HeyPCB/kestrel-fc/media/circuit-world.png

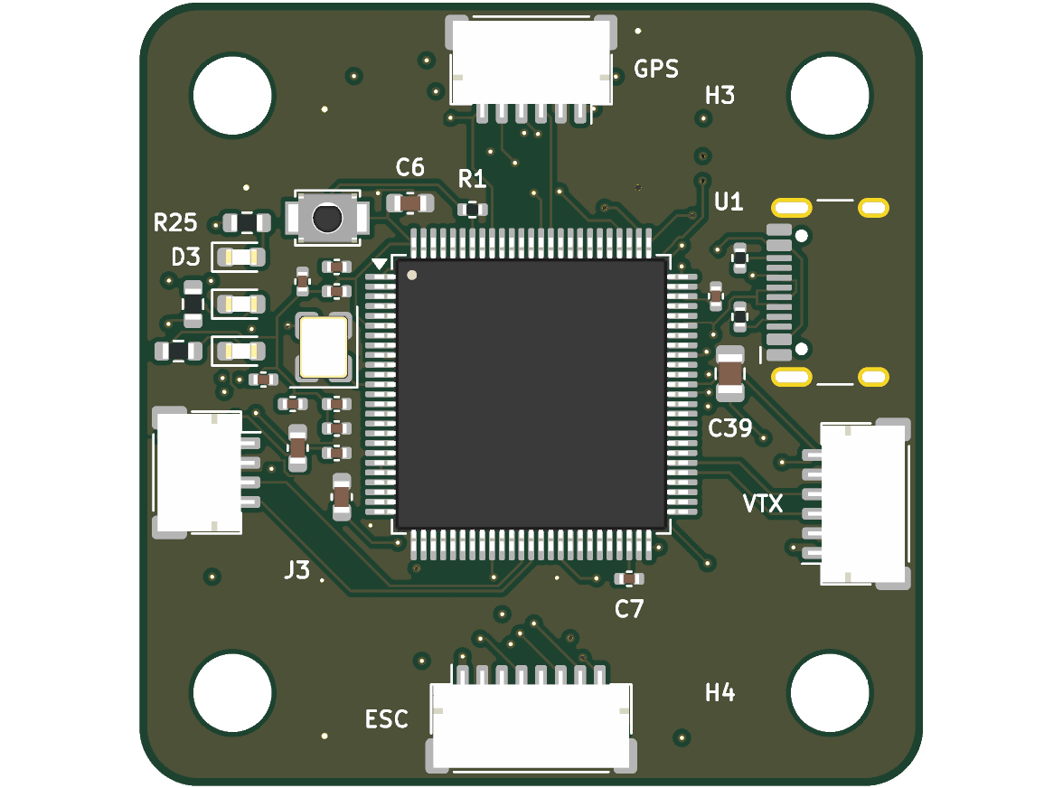
media/circuit-world.png
