HeyPCB/kestrel-fc/fab/kestrel_fc_bom.csv

Reference | Value | Footprint | MPN | LCSC | Qty
C1,C2,C3,C4,C5,C10,C11,C14,C15,C16,C17,C18,C19,C20,C22,C23,C26,C31 | 100nF | Capacitor_SMD:C_0402_1005Metric | CL05B104KO5NNNC | C1525 | 18
C6 | 4.7uF | Capacitor_SMD:C_0603_1608Metric | CL10A475KO8NNNC | C19666 | 1
C7,C8 | 2.2uF | Capacitor_SMD:C_0402_1005Metric | CL05A225MQ5NSNC | C12530 | 2
C9,C35,C36,C37,C38 | 1uF | Capacitor_SMD:C_0402_1005Metric | CL05A105KA5NQNC | C52923 | 5
C12,C13 | 12pF | Capacitor_SMD:C_0603_1608Metric | CL10C120JB8NNNC | C38523 | 2
C21,C24,C27,C28,C29,C32,C33,C34 | 10uF | Capacitor_SMD:C_0805_2012Metric | GRM21BR61H106KE43L | C440198 | 8
C25,C30 | 100nF | Capacitor_SMD:C_0402_1005Metric | CL05B104KB54PNC | C307331 | 2
C39 | 10uF | Capacitor_SMD:C_0805_2012Metric | CL21A106KAYNNNE | C15850 | 1
D1 | SMAJ30A | Diode_SMD:D_SMA | SMAJ30A | C908776 | 1
D2 | B5819W | Diode_SMD:D_SOD-123 | B5819W SL | C8598 | 1
D3 | Blue | LED_SMD:LED_0603_1608Metric | NCD0603B1 | C84266 | 1
D4 | Green | LED_SMD:LED_0603_1608Metric | KT-0603G | C12624 | 1
D5 | Red | LED_SMD:LED_0603_1608Metric | KT-0603R | C2286 | 1
J1 | ESC | Connector_JST:JST_SH_SM08B-SRSS-TB_1x08-1MP_P1.00mm_Horizontal | SM08B-SRSS-TB(LF)(SN) | C160407 | 1
J2 | VTX | Connector_JST:JST_SH_SM06B-SRSS-TB_1x06-1MP_P1.00mm_Horizontal | SM06B-SRSS-TB(LF)(SN) | C160405 | 1
J3 | RX | Connector_JST:JST_SH_SM04B-SRSS-TB_1x04-1MP_P1.00mm_Horizontal | SM04B-SRSS-TB(LF)(SN) | C160404 | 1
J4 | GPS | Connector_JST:JST_SH_SM06B-SRSS-TB_1x06-1MP_P1.00mm_Horizontal | SM06B-SRSS-TB(LF)(SN) | C160405 | 1
J5 | USB-C | Connector_USB:USB_C_Receptacle_HCTL_HC-TYPE-C-16P-01A | HC-TYPE-C-16P-01A | C2894897 | 1
L1 | 3.3uH | Inductor_SMD:L_Sunlord_SWPA5040S | SWPA5040S3R3MT | C14656 | 1
L2 | 6.8uH | Inductor_SMD:L_Sunlord_SWPA5040S | SWPA5040S6R8MT | C36411 | 1
Q1,Q2 | AO3400A | Package_TO_SOT_SMD:SOT-23 | AO3400A | C20917 | 2
R1,R2,R7,R8,R9,R10 | 10k | Resistor_SMD:R_0402_1005Metric | 0402WGF1002TCE | C25744 | 6
R3,R4,R28 | 33 | Resistor_SMD:R_0402_1005Metric | 0402WGF330JTCE | C25105 | 3
R5,R6 | 2.2k | Resistor_SMD:R_0402_1005Metric | 0402WGF2201TCE | C25879 | 2
R11,R12 | 1k | Resistor_SMD:R_0402_1005Metric | 0402WGF1001TCE | C11702 | 2
R13,R15,R16,R18,R19,R24 | 100k | Resistor_SMD:R_0603_1608Metric | 0603WAF1003T5E | C25803 | 6
R14 | 13.7k | Resistor_SMD:R_0603_1608Metric | 0603WAF1372T5E | C22793 | 1
R17 | 6.49k | Resistor_SMD:R_0603_1608Metric | 0603WAF6491T5E | C23088 | 1
R20,R21 | 100k | Resistor_SMD:R_0402_1005Metric | 0402WGF1003TCE | C25741 | 2
R22,R23 | 5.1k | Resistor_SMD:R_0402_1005Metric | 0402WGF5101TCE | C25905 | 2
R25,R26,R27 | 1k | Resistor_SMD:R_0603_1608Metric | 0603WAF1001T5E | C21190 | 3
SW1 | BOOT | Button_Switch_SMD:SW_SPST_B3U-1000P | B3U-1000P | C231329 | 1
U1 | STM32H743VIT6 | Package_QFP:LQFP-100_14x14mm_P0.5mm | STM32H743VIT6 | C114409 | 1
U2 | ICM-20602 | Package_LGA:LGA-16_3x3mm_P0.5mm_LayoutBorder3x5y | ICM-20602 | C97633 | 1
U3 | BMI088 | Package_LGA:Bosch_LGA-16_4.5x3mm_P0.5mm_LayoutBorder7x1y_ClockwisePinNumbering | BMI088 | C194919 | 1
U4 | MS5611 | Package_LGA:LGA-8_3x5mm_P1.25mm | MS561101BA03-50 | C15639 | 1
U5 | W25Q128JVSIQ | Package_SO:SOIC-8_5.3x5.3mm_P1.27mm | W25Q128JVSIQ | C97521 | 1
U6,U7 | LMR51430YF | Package_TO_SOT_SMD:SOT-23-6 | LMR51430YFDDCR | C5219261 | 2
U8,U9 | AP2112K-3.3 | Package_TO_SOT_SMD:SOT-23-5 | AP2112K-3.3TRG1 | C51118 | 2
U10 | USBLC6-2SC6 | Package_TO_SOT_SMD:SOT-23-6 | USBLC6-2SC6 | C7519 | 1
Y1 | 8MHz | Crystal:Crystal_SMD_3225-4Pin_3.2x2.5mm | TAXM8M4RDBCCT2T | C400090 | 1
