HeyPCB/kestrel-fc/bom_cost.md

| Refs | Value | Qty | LCSC | MPN | Class | Unit @10 | Line |
|---|---|---|---|---|---|---|---|
| C1,C2,C3,C4,C5,C10,C11,C14,C15,C16,C17,C18,C19,C20,C22,C23,C26,C31 | 100nF | 18 | C1525 | CL05B104KO5NNNC | basic | $0.0060 | $0.1080 |
| C6 | 4.7uF | 1 | C19666 | CL10A475KO8NNNC | basic | $0.0236 | $0.0236 |
| C7,C8 | 2.2uF | 2 | C12530 | CL05A225MQ5NSNC | basic | $0.0078 | $0.0156 |
| C9,C35,C36,C37,C38 | 1uF | 5 | C52923 | CL05A105KA5NQNC | basic | $0.0143 | $0.0715 |
| C12,C13 | 12pF | 2 | C38523 | CL10C120JB8NNNC | basic | $0.0081 | $0.0162 |
| C21,C24,C27,C28,C29,C32,C33,C34 | 10uF | 8 | C440198 | GRM21BR61H106KE43L | basic | $0.2473 | $1.9784 |
| C25,C30 | 100nF | 2 | C307331 | CL05B104KB54PNC | basic | $0.0076 | $0.0152 |
| C39 | 10uF | 1 | C15850 | CL21A106KAYNNNE | basic | $0.0773 | $0.0773 |
| D1 | SMAJ30A | 1 | C908776 | SMAJ30A | extended | $0.0349 | $0.0349 |
| D2 | B5819W | 1 | C8598 | B5819W SL | basic | $0.0261 | $0.0261 |
| D3 | Blue | 1 | C84266 | NCD0603B1 | extended | $0.0170 | $0.0170 |
| D4 | Green | 1 | C12624 | KT-0603G | extended | $0.0122 | $0.0122 |
| D5 | Red | 1 | C2286 | KT-0603R | basic | $0.0073 | $0.0073 |
| J1 | ESC | 1 | C160407 | SM08B-SRSS-TB(LF)(SN) | extended | $0.3188 | $0.3188 |
| J2 | VTX | 1 | C160405 | SM06B-SRSS-TB(LF)(SN) | extended | $0.3020 | $0.3020 |
| J3 | RX | 1 | C160404 | SM04B-SRSS-TB(LF)(SN) | extended | $0.2262 | $0.2262 |
| J4 | GPS | 1 | C160405 | SM06B-SRSS-TB(LF)(SN) | extended | $0.3020 | $0.3020 |
| J5 | USB-C | 1 | C2894897 | HC-TYPE-C-16P-01A | extended | $0.0998 | $0.0998 |
| L1 | 3.3uH | 1 | C14656 | SWPA5040S3R3MT | extended | $0.0783 | $0.0783 |
| L2 | 6.8uH | 1 | C36411 | SWPA5040S6R8MT | extended | $0.0803 | $0.0803 |
| Q1,Q2 | AO3400A | 2 | C20917 | AO3400A | basic | $0.0846 | $0.1692 |
| R1,R2,R7,R8,R9,R10 | 10k | 6 | C25744 | 0402WGF1002TCE | basic | $0.0029 | $0.0174 |
| R3,R4,R28 | 33 | 3 | C25105 | 0402WGF330JTCE | basic | $0.0010 | $0.0030 |
| R5,R6 | 2.2k | 2 | C25879 | 0402WGF2201TCE | basic | $0.0010 | $0.0020 |
| R11,R12 | 1k | 2 | C11702 | 0402WGF1001TCE | basic | $0.0011 | $0.0022 |
| R13,R15,R16,R18,R19,R24 | 100k | 6 | C25803 | 0603WAF1003T5E | basic | $0.0016 | $0.0096 |
| R14 | 13.7k | 1 | C22793 | 0603WAF1372T5E | extended | $0.0021 | $0.0021 |
| R17 | 6.49k | 1 | C23088 | 0603WAF6491T5E | extended | $0.0013 | $0.0013 |
| R20,R21 | 100k | 2 | C25741 | 0402WGF1003TCE | basic | $0.0040 | $0.0080 |
| R22,R23 | 5.1k | 2 | C25905 | 0402WGF5101TCE | basic | $0.0009 | $0.0018 |
| R25,R26,R27 | 1k | 3 | C21190 | 0603WAF1001T5E | basic | $0.0039 | $0.0117 |
| SW1 | BOOT | 1 | C231329 | B3U-1000P | extended | $0.1784 | $0.1784 |
| U1 | STM32H743VIT6 | 1 | C114409 | STM32H743VIT6 | extended | $8.3101 | $8.3101 |
| U2 | ICM-20602 | 1 | C97633 | ICM-20602 | extended | $6.2635 | $6.2635 |
| U3 | BMI088 | 1 | C194919 | BMI088 | extended | $11.3230 | $11.3230 |
| U4 | MS5611 | 1 | C15639 | MS561101BA03-50 | extended | $6.2798 | $6.2798 |
| U5 | W25Q128JVSIQ | 1 | C97521 | W25Q128JVSIQ | basic | $2.1231 | $2.1231 |
| U6,U7 | LMR51430YF | 2 | C5219261 | LMR51430YFDDCR | extended | $0.6718 | $1.3436 |
| U8,U9 | AP2112K-3.3 | 2 | C51118 | AP2112K-3.3TRG1 | extended | $0.1577 | $0.3154 |
| U10 | USBLC6-2SC6 | 1 | C7519 | USBLC6-2SC6 | extended | $0.1639 | $0.1639 |
| Y1 | 8MHz | 1 | C400090 | TAXM8M4RDBCCT2T | extended | $0.1458 | $0.1458 |
| | **Parts** | | | | | | **$40.49** |
| | Extended-part loading fee ($3 x 20 / 10 boards) | | | | | | $6.00 |
| | **BOM per board @10** | | | | | | **$46.49** |
