HeyPCB/kestrel-fc/fab/kestrel_fc.step

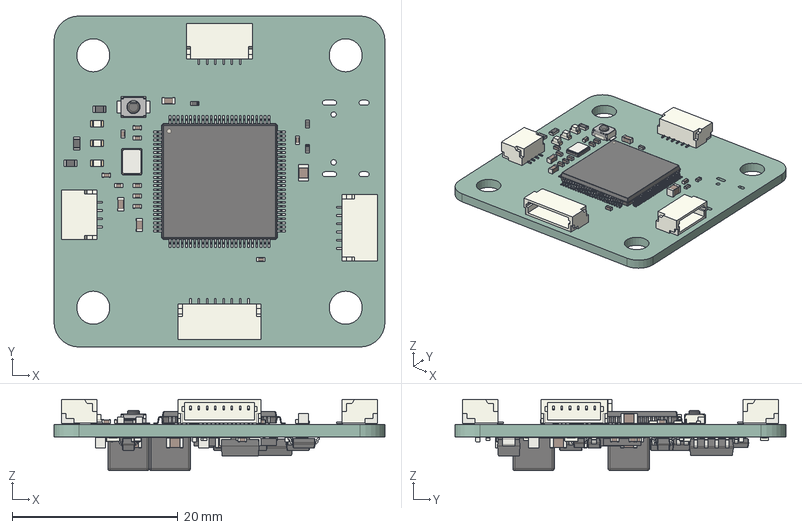
[picture p5: CAD file, 2026-10-06]
fab/kestrel_fc.step
40.0 x 40.0 x 8.64 mm
R_0603_1608Metric x 11
JST_SH_SM08B-SRSS-TB_1x08-1MP_P1.00mm_Horizontal
C_0402_1005Metric x 27
Crystal_SMD_3225-4Pin_3.2x2.5mm
C_0603_1608Metric x 3
SW_SPST_B3U-1000P
LED_0603_1608Metric x 3
JST_SH_SM06B-SRSS-TB_1x06-1MP_P1.00mm_Horizontal x 2
LQFP-100_14x14mm_P0.5mm
C_0805_2012Metric x 9
JST_SH_SM04B-SRSS-TB_1x04-1MP_P1.00mm_Horizontal
R_0402_1005Metric x 17
SOT-23 x 2
a69dfe88-8551-11ed-a139-00155d22e2d7_part x 2
a69dffdc-8551-11ed-a139-00155d22e2d7_part x 2
a69e005e-8551-11ed-a139-00155d22e2d7_part x 2
SOIC-8_5.3x5.3mm_P1.27mm
SOT-23-5 x 2
D_SOD-123
SOT-23-6 x 3
LGA_8_3x5mm_P125mm
Bosch_LGA-16_4.5x3mm_P0.5mm_LayoutBorder7x1y_ClockwisePinNumbering
D_SMA
LGA_16_3x3mm_P05mm_LayoutBorder3x5y
kestrel_fc_3d_PCB
