HeyPCB/kestrel-fc/fab/kestrel_fc_schematic.pdf

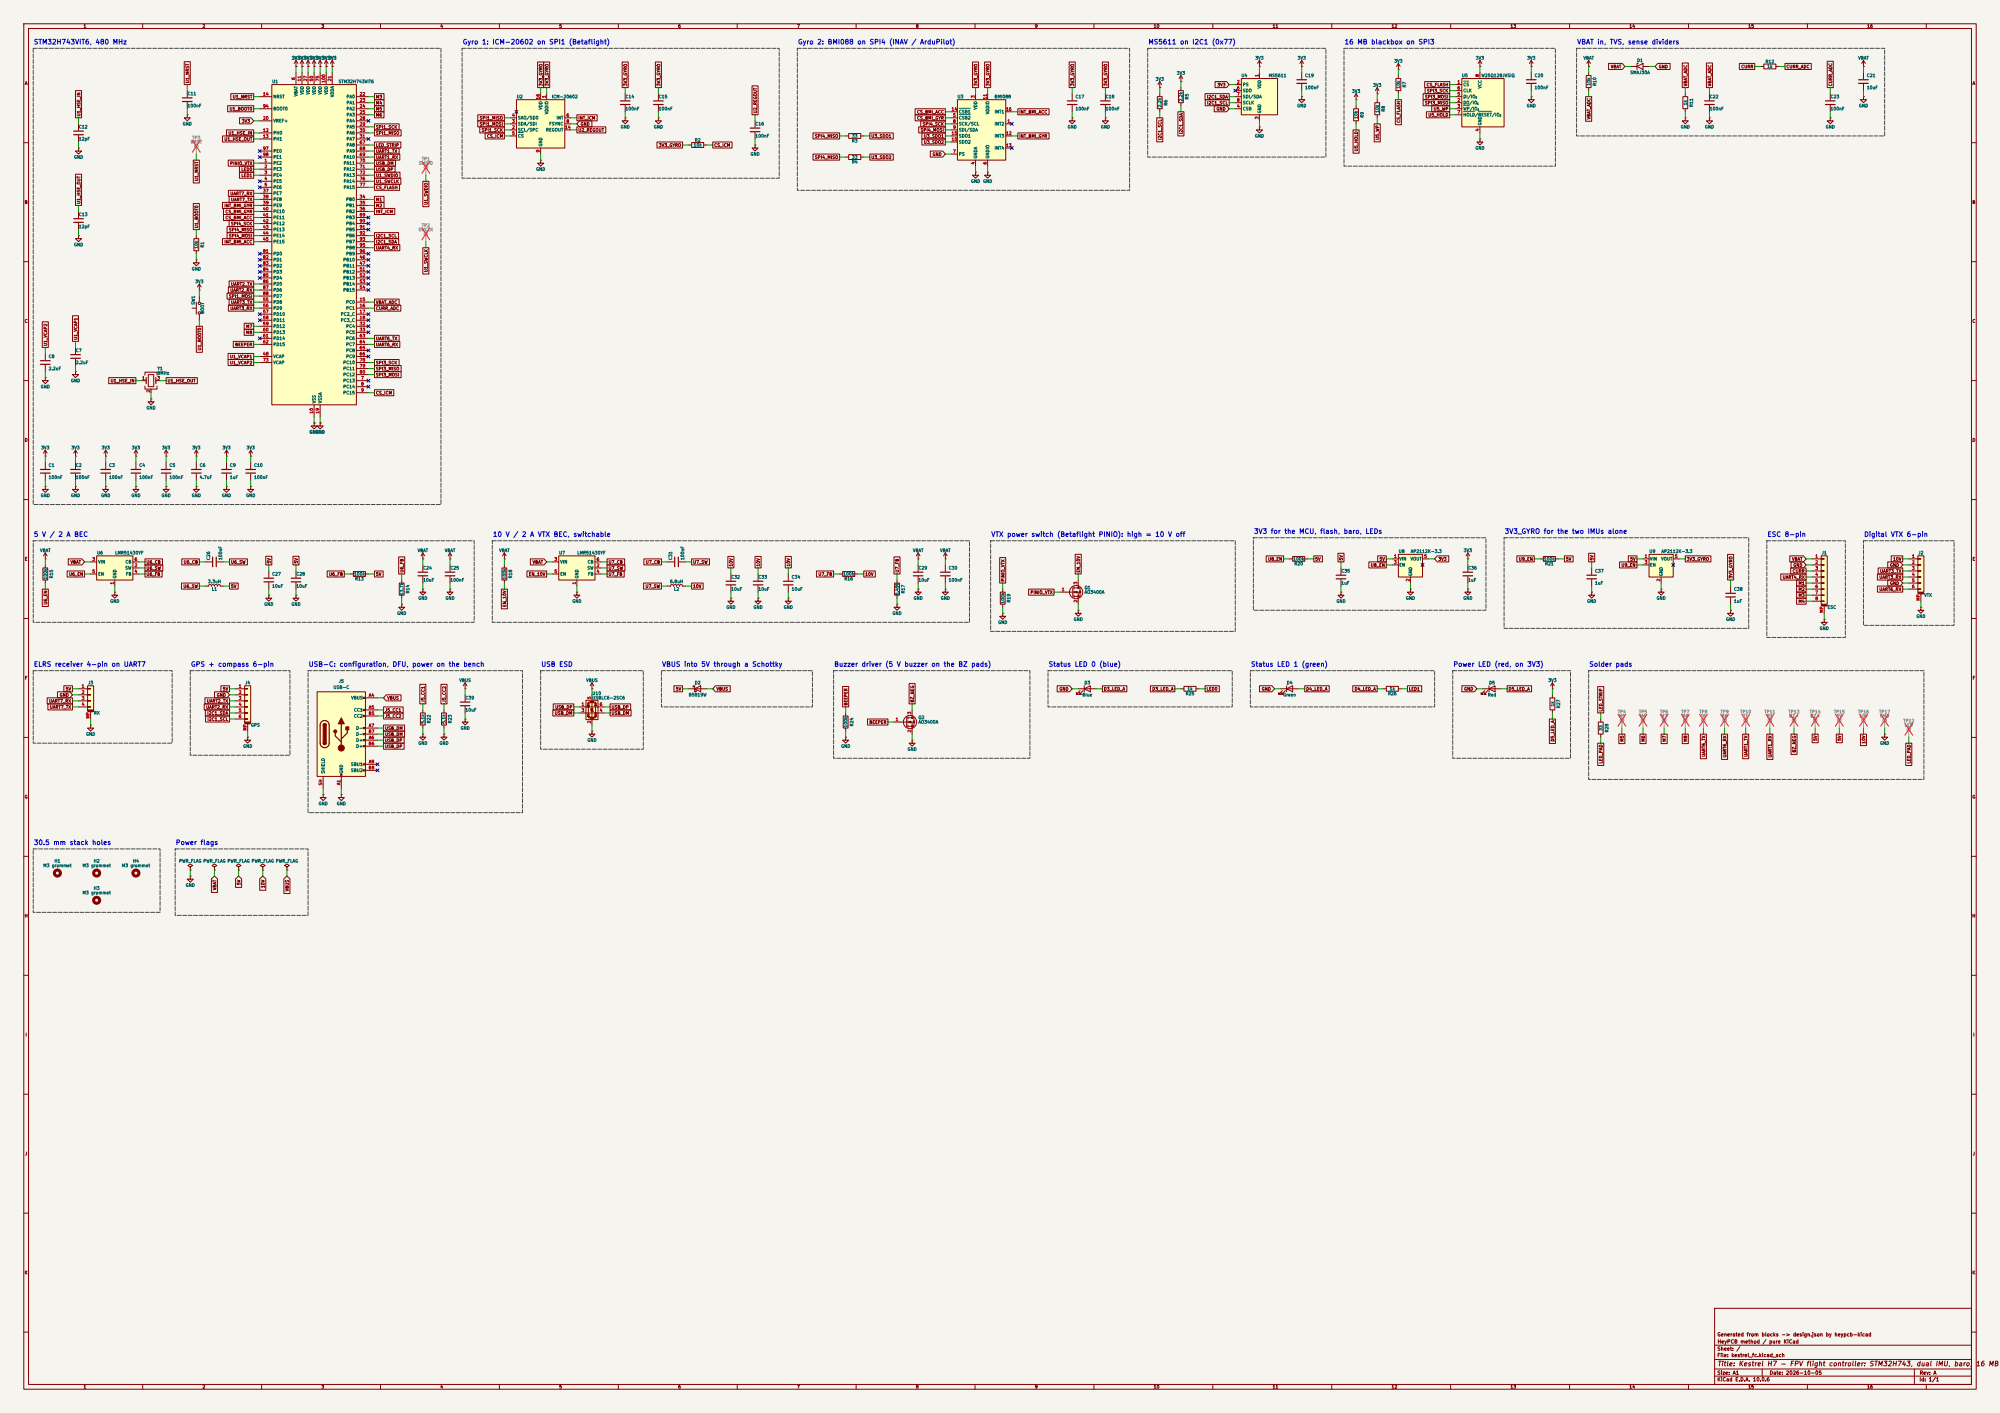
[picture p6: page 1]

USB-C: configuration, DFU, power on the bench

VBUS into 5V through a Schottky

Buzzer driver (5 V buzzer on the BZ pads)

Generated from blocks -> design.json by heypcb-kicad
HeyPCB method / pure KiCad
Sheet: /
File: kestrel_fc.kicad_sch
Title: Kestrel H7 - FPV flight controller: STM32H743, dual IMU, baro, 16 MB blackbox, 5 V + 10 V BECs, 2-6S

Size: A1 | Rev: A
KiCad E.D.A. 10.0.6 | Id: 1/1
