HeyPCB/kestrel-fc/kicad/kestrel_fc.kicad_pcb

## KiCad design kicad/kestrel_fc.kicad_pcb (2026-10-06)

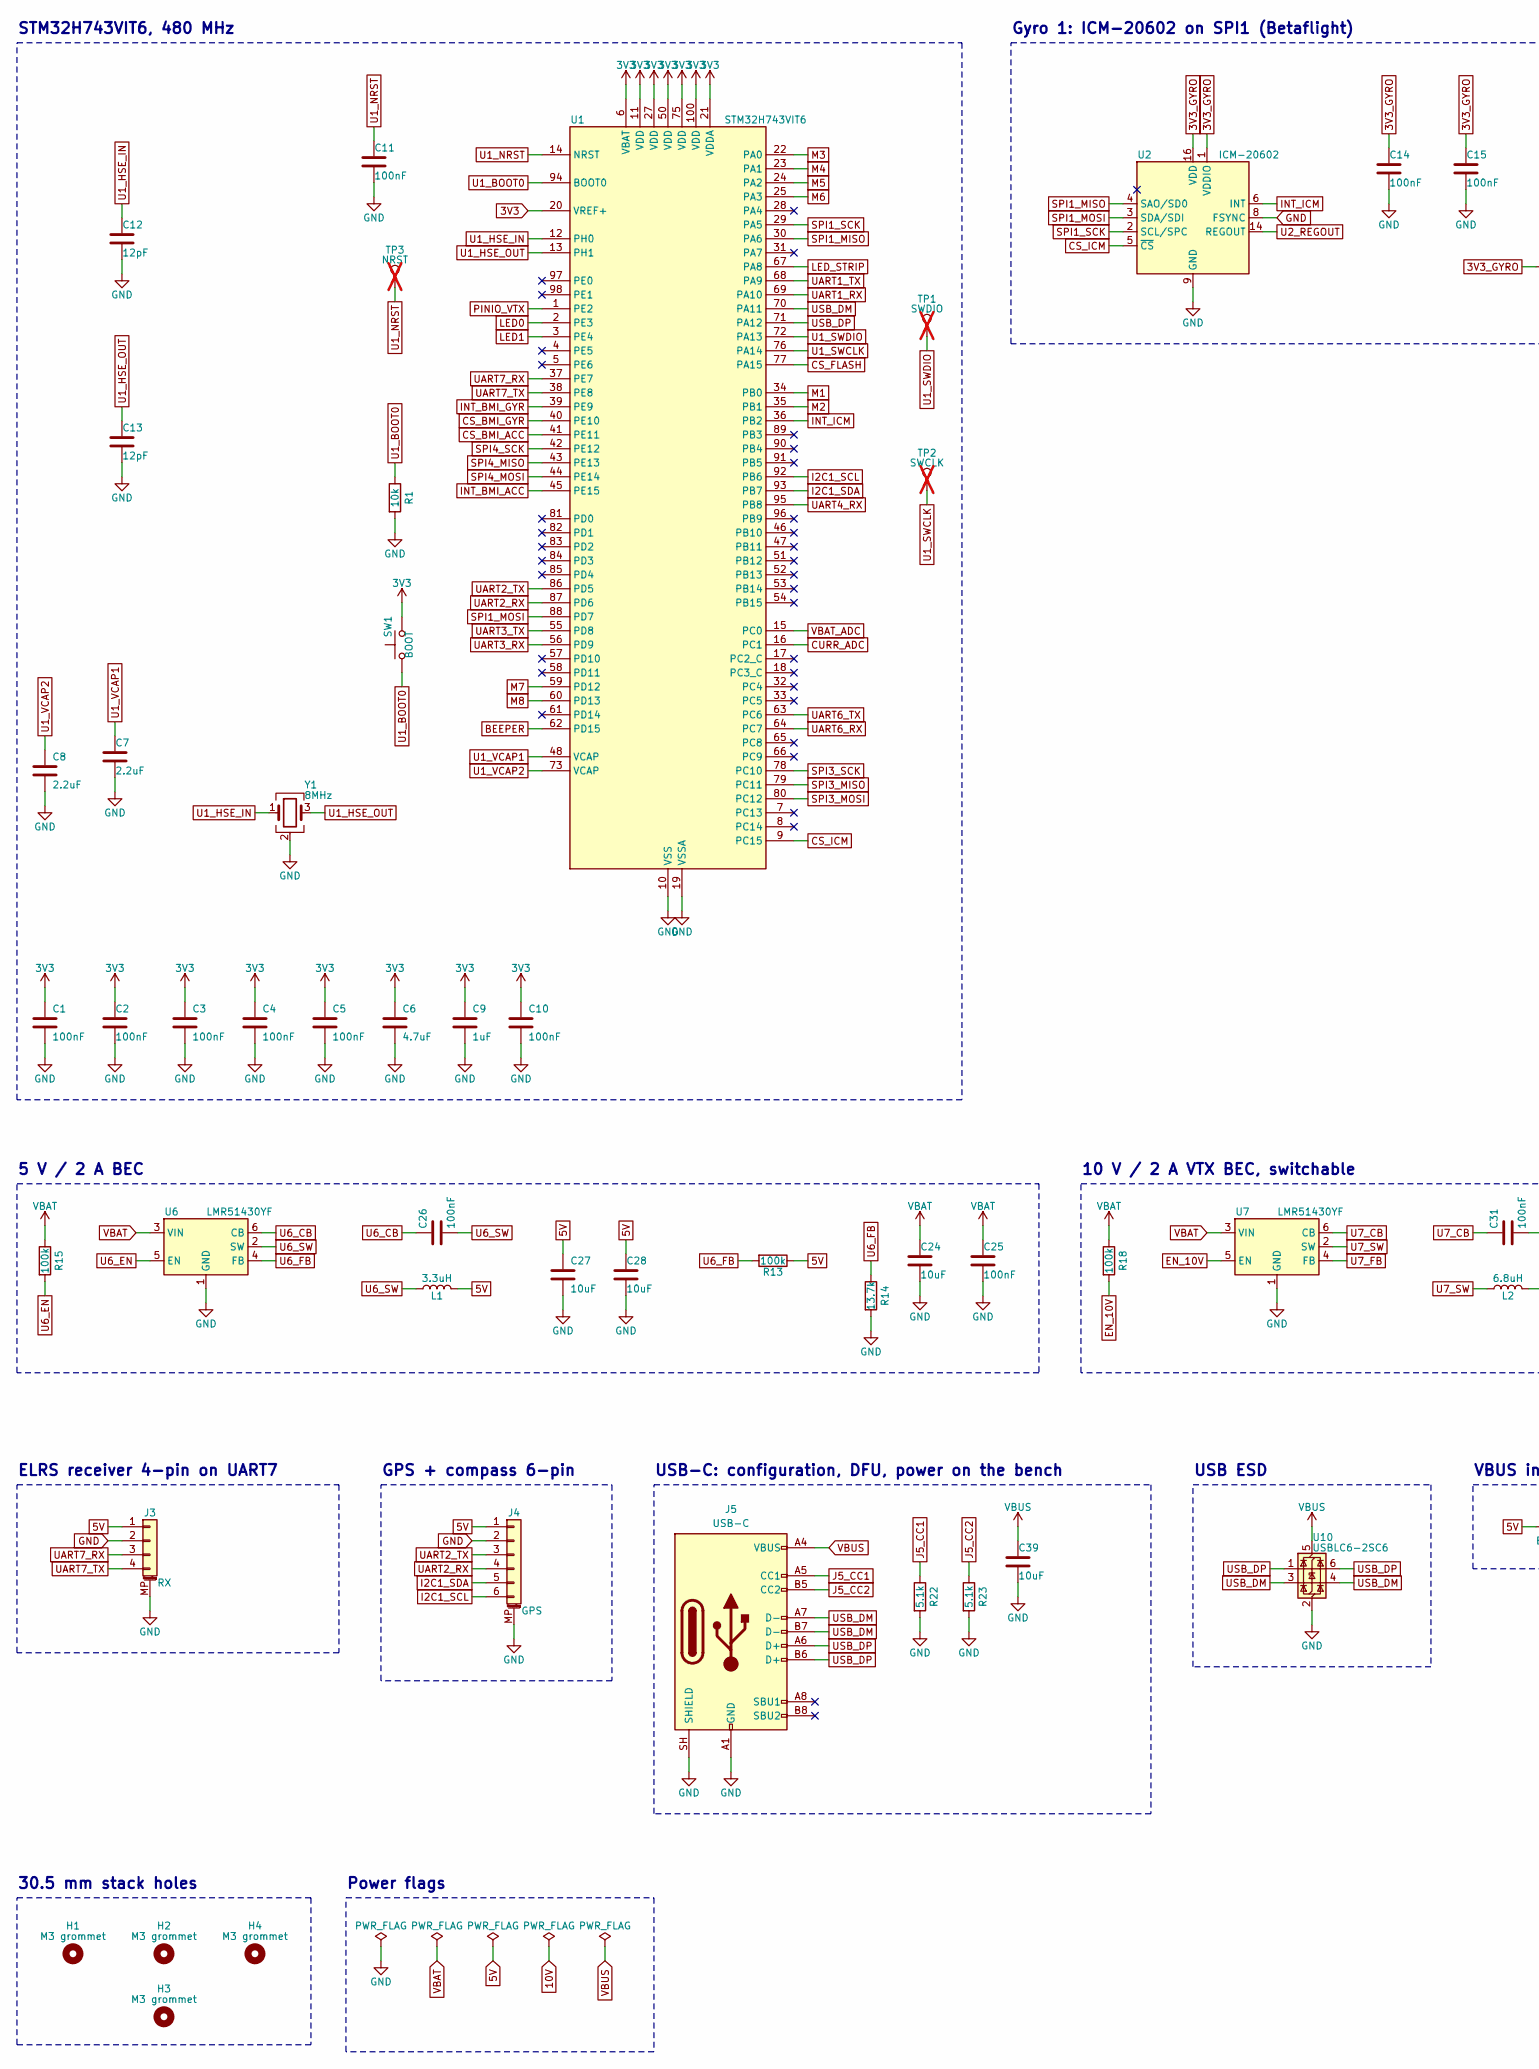
[picture p7: schematic kestrel_fc.kicad_sch, Kestrel H7 - FPV flight controller: STM32H743, dual IMU, ba…, part in row 1, column 1]

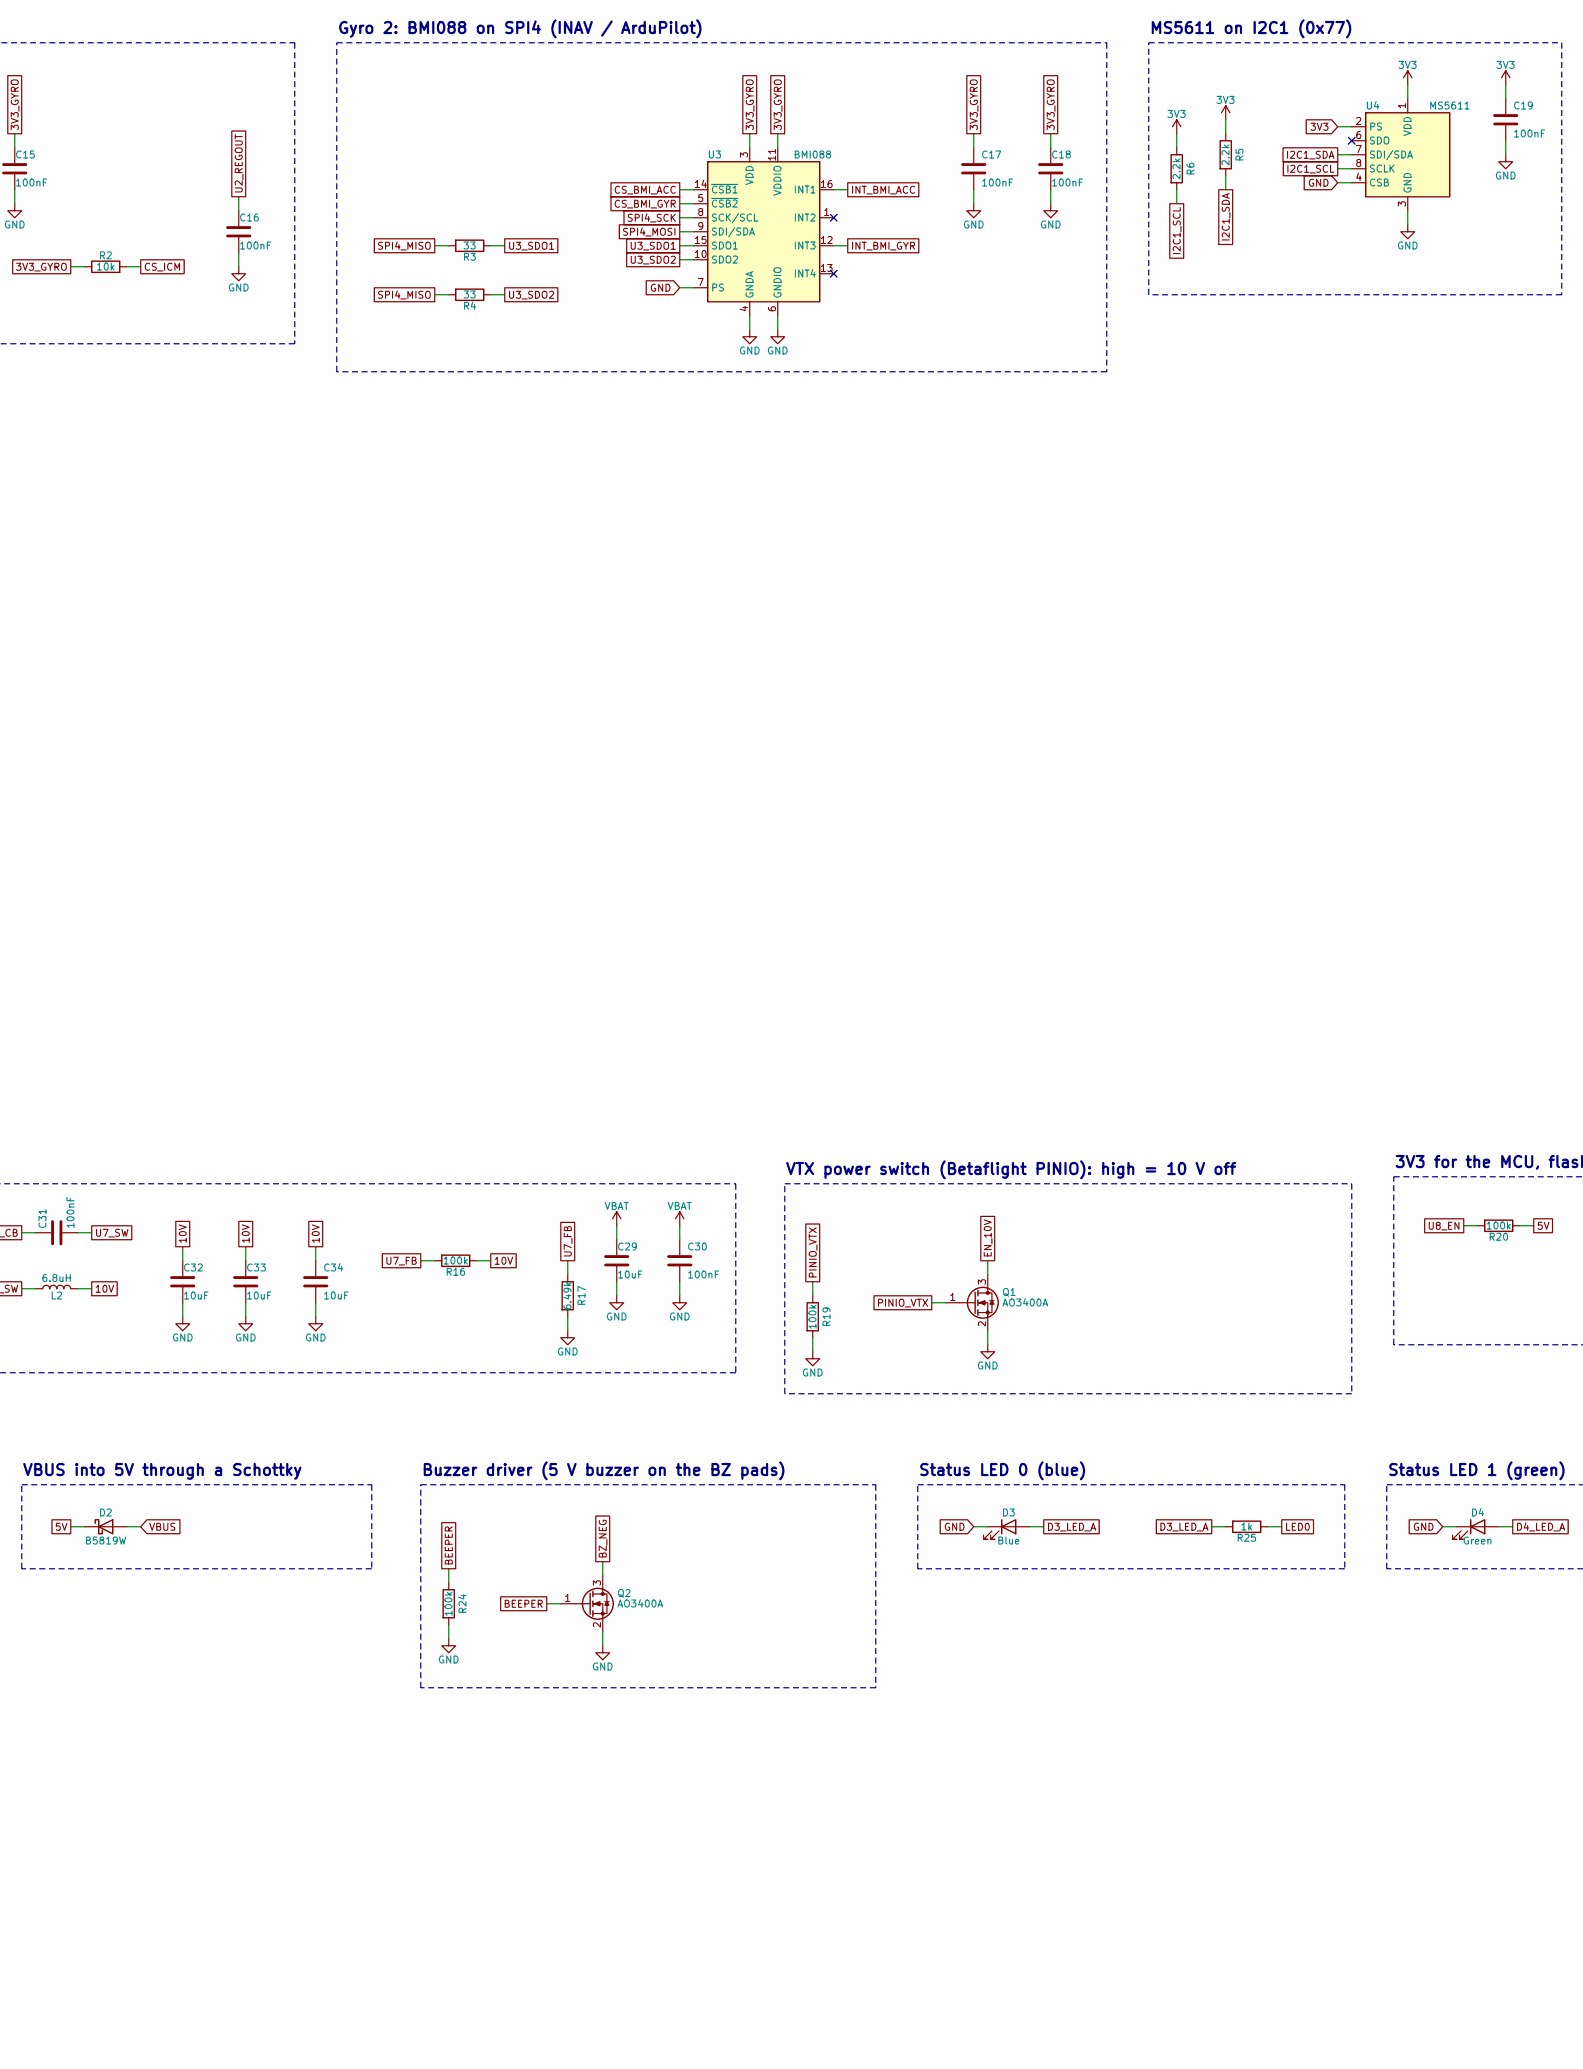
[picture p8: schematic kestrel_fc.kicad_sch, Kestrel H7 - FPV flight controller: STM32H743, dual IMU, ba…, part in row 1, column 2]

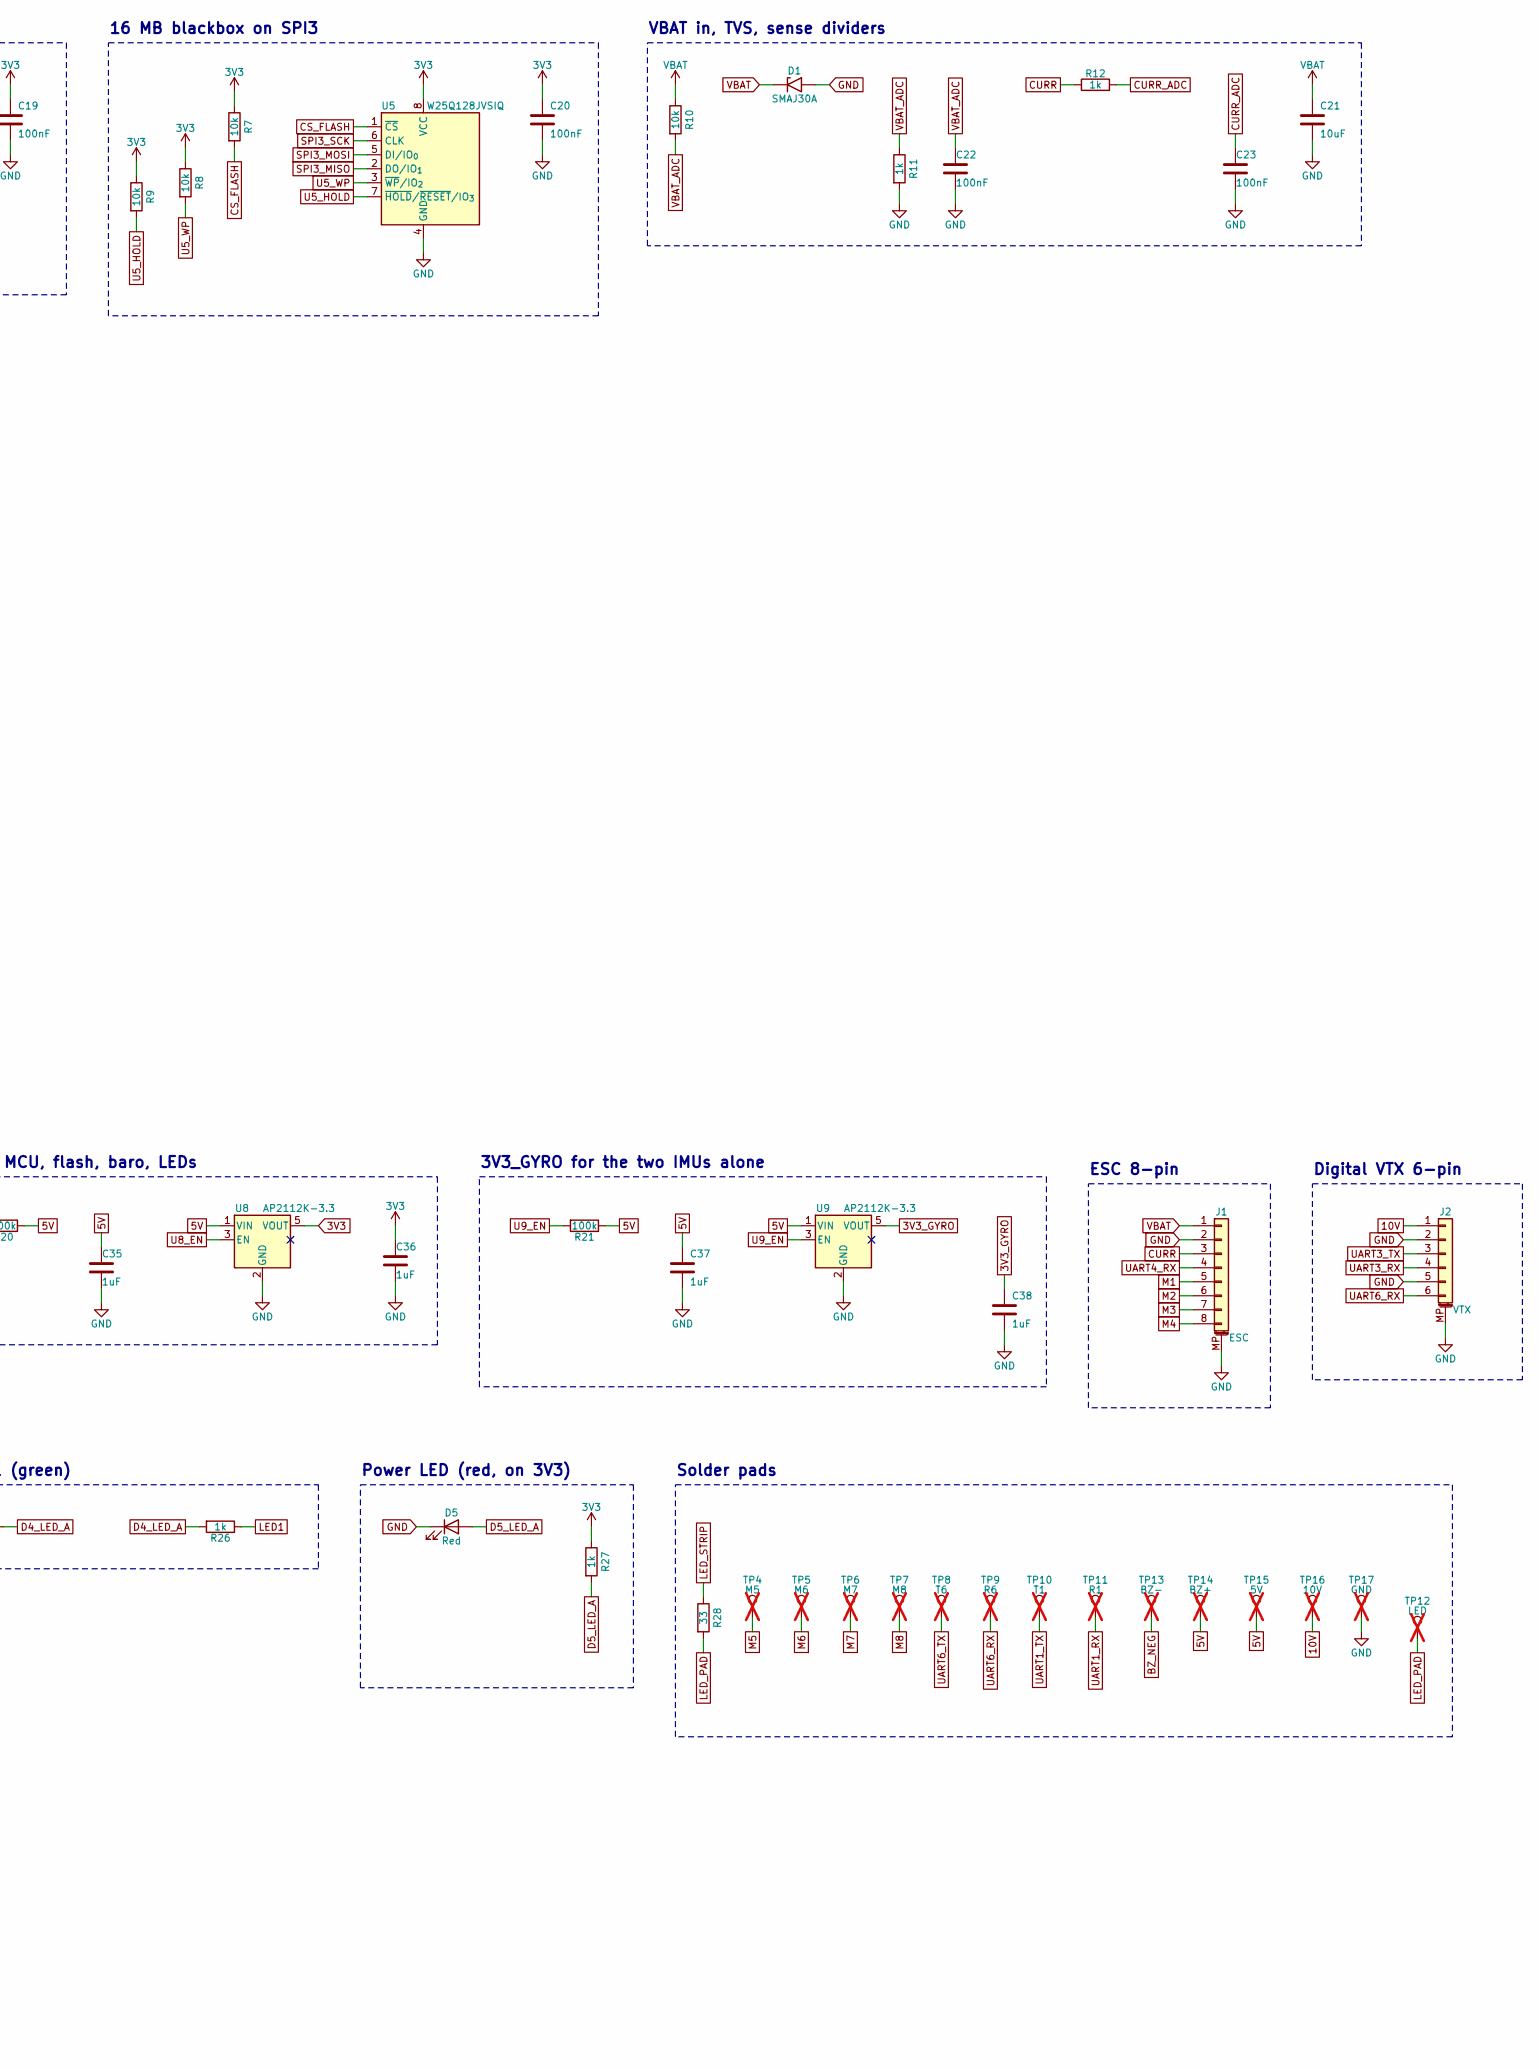
[picture p9: schematic kestrel_fc.kicad_sch, Kestrel H7 - FPV flight controller: STM32H743, dual IMU, ba…, part in row 1, column 3]

Parts:
C1, C2, C3, C4, C5, C10, C11, C14, C15, C16, C17, C18, C19, C20, C22, C23, C26, C31: 100nF; C_0402_1005Metric; MPN CL05B104KO5NNNC; LCSC C1525
C6: 4.7uF; C_0603_1608Metric; MPN CL10A475KO8NNNC; LCSC C19666
C7, C8: 2.2uF; C_0402_1005Metric; MPN CL05A225MQ5NSNC; LCSC C12530
C9, C35, C36, C37, C38: 1uF; C_0402_1005Metric; MPN CL05A105KA5NQNC; LCSC C52923
C12, C13: 12pF; C_0603_1608Metric; MPN CL10C120JB8NNNC; LCSC C38523
C21, C24, C27, C28, C29, C32, C33, C34: 10uF; C_0805_2012Metric; MPN GRM21BR61H106KE43L; LCSC C440198
C25, C30: 100nF; C_0402_1005Metric; MPN CL05B104KB54PNC; LCSC C307331
C39: 10uF; C_0805_2012Metric; MPN CL21A106KAYNNNE; LCSC C15850
D1: SMAJ30A; D_SMA; MPN SMAJ30A; LCSC C908776
D2: B5819W; D_SOD-123; MPN B5819W SL; LCSC C8598
D3: Blue; LED_0603_1608Metric; MPN NCD0603B1; LCSC C84266
D4: Green; LED_0603_1608Metric; MPN KT-0603G; LCSC C12624
D5: Red; LED_0603_1608Metric; MPN KT-0603R; LCSC C2286
H1, H2, H3, H4: M3 grommet; MountingHole_4mm
J1: ESC; JST_SH_SM08B-SRSS-TB_1x08-1MP_P1.00mm_Horizontal; MPN SM08B-SRSS-TB(LF)(SN); LCSC C160407
J2: VTX; JST_SH_SM06B-SRSS-TB_1x06-1MP_P1.00mm_Horizontal; MPN SM06B-SRSS-TB(LF)(SN); LCSC C160405
J3: RX; JST_SH_SM04B-SRSS-TB_1x04-1MP_P1.00mm_Horizontal; MPN SM04B-SRSS-TB(LF)(SN); LCSC C160404
J4: GPS; JST_SH_SM06B-SRSS-TB_1x06-1MP_P1.00mm_Horizontal; MPN SM06B-SRSS-TB(LF)(SN); LCSC C160405
J5: USB-C; USB_C_Receptacle_HCTL_HC-TYPE-C-16P-01A; MPN HC-TYPE-C-16P-01A; LCSC C2894897
L1: 3.3uH; L_Sunlord_SWPA5040S; MPN SWPA5040S3R3MT; LCSC C14656
L2: 6.8uH; L_Sunlord_SWPA5040S; MPN SWPA5040S6R8MT; LCSC C36411
Q1, Q2: AO3400A; SOT-23; MPN AO3400A; LCSC C20917
R1, R2, R7, R8, R9, R10: 10k; R_0402_1005Metric; MPN 0402WGF1002TCE; LCSC C25744
R3, R4, R28: 33; R_0402_1005Metric; MPN 0402WGF330JTCE; LCSC C25105
R5, R6: 2.2k; R_0402_1005Metric; MPN 0402WGF2201TCE; LCSC C25879
R11, R12: 1k; R_0402_1005Metric; MPN 0402WGF1001TCE; LCSC C11702
R13, R15, R16, R18, R19, R24: 100k; R_0603_1608Metric; MPN 0603WAF1003T5E; LCSC C25803
R14: 13.7k; R_0603_1608Metric; MPN 0603WAF1372T5E; LCSC C22793
R17: 6.49k; R_0603_1608Metric; MPN 0603WAF6491T5E; LCSC C23088
R20, R21: 100k; R_0402_1005Metric; MPN 0402WGF1003TCE; LCSC C25741
R22, R23: 5.1k; R_0402_1005Metric; MPN 0402WGF5101TCE; LCSC C25905
R25, R26, R27: 1k; R_0603_1608Metric; MPN 0603WAF1001T5E; LCSC C21190
SW1: BOOT; SW_SPST_B3U-1000P; MPN B3U-1000P; LCSC C231329
TP1: SWDIO; TestPoint_Pad_1.0x1.0mm; not fitted
TP2: SWCLK; TestPoint_Pad_1.0x1.0mm; not fitted
TP3: NRST; TestPoint_Pad_1.0x1.0mm; not fitted
TP4: M5; TestPoint_Pad_1.5x1.5mm; not fitted
TP5: M6; TestPoint_Pad_1.5x1.5mm; not fitted
TP6: M7; TestPoint_Pad_1.5x1.5mm; not fitted
TP7: M8; TestPoint_Pad_1.5x1.5mm; not fitted
TP8: T6; TestPoint_Pad_1.5x1.5mm; not fitted
TP9: R6; TestPoint_Pad_1.5x1.5mm; not fitted
TP10: T1; TestPoint_Pad_1.5x1.5mm; not fitted
TP11: R1; TestPoint_Pad_1.5x1.5mm; not fitted
TP12: LED; TestPoint_Pad_1.5x1.5mm; not fitted
TP13: BZ-; TestPoint_Pad_1.5x1.5mm; not fitted
TP14: BZ+; TestPoint_Pad_1.5x1.5mm; not fitted
TP15: 5V; TestPoint_Pad_1.5x1.5mm; not fitted
TP16: 10V; TestPoint_Pad_1.5x1.5mm; not fitted
TP17: GND; TestPoint_Pad_1.5x1.5mm; not fitted
U1: STM32H743VIT6; LQFP-100_14x14mm_P0.5mm; MPN STM32H743VIT6; LCSC C114409
U2: ICM-20602; LGA-16_3x3mm_P0.5mm_LayoutBorder3x5y; MPN ICM-20602; LCSC C97633
U3: BMI088; Bosch_LGA-16_4.5x3mm_P0.5mm_LayoutBorder7x1y_ClockwisePinNu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; MPN BMI088; LCSC C194919
U4: MS5611; LGA-8_3x5mm_P1.25mm; MPN MS561101BA03-50; LCSC C15639
U5: W25Q128JVSIQ; SOIC-8_5.3x5.3mm_P1.27mm; MPN W25Q128JVSIQ; LCSC C97521
U6, U7: LMR51430YF; SOT-23-6; MPN LMR51430YFDDCR; LCSC C5219261
U8, U9: AP2112K-3.3; SOT-23-5; MPN AP2112K-3.3TRG1; LCSC C51118
U10: USBLC6-2SC6; SOT-23-6; MPN USBLC6-2SC6; LCSC C7519
Y1: 8MHz; Crystal_SMD_3225-4Pin_3.2x2.5mm; MPN TAXM8M4RDBCCT2T; LCSC C400090

Connections:
3V3: C1.1, C2.1, C3.1, C4.1, C5.1, C6.1, C9.1, C10.1, C19.1, C20.1, C36.1, R5.1, R6.1, R7.1, R8.1, R9.1, R27.1, SW1.2, U1.6 (VBAT), U1.11 (VDD), U1.20 (VREF+), U1.21 (VDDA), U1.27 (VDD), U1.50 (VDD), U1.75 (VDD), U1.100 (VDD), U4.1 (VDD), U4.2 (PS), U5.8 (VCC), U8.5 (VOUT)
3V3_GYRO: C14.1, C15.1, C17.1, C18.1, C38.1, R2.1, U2.1 (VDDIO), U2.16 (VDD), U3.3 (VDD), U3.11 (VDDIO), U9.5 (VOUT)
5V: C27.1, C28.1, C35.1, C37.1, D2.1 (K), J3.1, J4.1, L1.2, R13.1, R20.1, R21.1, TP14.1, TP15.1, U8.1 (VIN), U9.1 (VIN)
10V: C32.1, C33.1, C34.1, J2.1, L2.2, R16.1, TP16.1
BEEPER: Q2.1 (G), R24.1, U1.62 (PD15)
BZ_NEG: Q2.3 (D), TP13.1
CS_BMI_ACC: U1.41 (PE11), U3.14 (~CSB1)
CS_BMI_GYR: U1.40 (PE10), U3.5 (~CSB2)
CS_FLASH: R7.2, U1.77 (PA15), U5.1 (~CS)
CS_ICM: R2.2, U1.9 (PC15), U2.5 (~CS)
CURR: J1.3, R12.1
CURR_ADC: C23.1, R12.2, U1.16 (PC1)
D3_LED_A: D3.2 (A), R25.2
D4_LED_A: D4.2 (A), R26.2
D5_LED_A: D5.2 (A), R27.2
EN_10V: Q1.3 (D), R18.2, U7.5 (EN)
GND: C1.2, C2.2, C3.2, C4.2, C5.2, C6.2, C7.2, C8.2, C9.2, C10.2, C11.2, C12.2, C13.2, C14.2, C15.2, C16.2, C17.2, C18.2, C19.2, C20.2, C21.2, C22.2, C23.2, C24.2, C25.2, C27.2, C28.2, C29.2, C30.2, C32.2, C33.2, C34.2, C35.2, C36.2, C37.2, C38.2, C39.2, D1.2 (A2), D3.1 (K), D4.1 (K), D5.1 (K), J1.2, J1.MP (MountPin), J2.2, J2.5, J2.MP (MountPin), J3.2, J3.MP (MountPin), J4.2, J4.MP (MountPin), J5.A1 (GND), J5.A12 (GND), J5.B1 (GND), J5.B12 (GND), J5.SH (SHIELD), Q1.2 (S), Q2.2 (S), R1.2, R11.2, R14.2, R17.2, R19.2, R22.2, R23.2, R24.2, TP17.1, U1.10 (VSS), U1.19 (VSSA), U1.26 (VSS), U1.49 (VSS), U1.74 (VSS), U1.99 (VSS), U2.8 (FSYNC), U2.9 (GND), U2.10 (GND), U2.11 (GND), U2.12 (GND), U2.13 (GND), U2.15 (GND), U3.2 (GNDA), U3.4 (GNDA), U3.6 (GNDIO), U3.7 (PS), U4.3 (GND), U4.4 (CSB), U4.5 (CSB), U5.4 (GND), U6.1 (GND), U7.1 (GND), U8.2 (GND), U9.2 (GND), U10.2 (GND), Y1.2 (G), Y1.4 (G)
I2C1_SCL: J4.6, R6.2, U1.92 (PB6), U4.8 (SCLK)
I2C1_SDA: J4.5, R5.2, U1.93 (PB7), U4.7 (SDI/SDA)
INT_BMI_ACC: U1.45 (PE15), U3.16 (INT1)
INT_BMI_GYR: U1.39 (PE9), U3.12 (INT3)
INT_ICM: U1.36 (PB2), U2.6 (INT)
J5_CC1: J5.A5 (CC1), R22.1
J5_CC2: J5.B5 (CC2), R23.1
LED0: R25.1, U1.2 (PE3)
LED1: R26.1, U1.3 (PE4)
LED_PAD: R28.2, TP12.1
LED_STRIP: R28.1, U1.67 (PA8)
M1: J1.5, U1.34 (PB0)
M2: J1.6, U1.35 (PB1)
M3: J1.7, U1.22 (PA0)
M4: J1.8, U1.23 (PA1)
M5: TP4.1, U1.24 (PA2)
M6: TP5.1, U1.25 (PA3)
M7: TP6.1, U1.59 (PD12)
M8: TP7.1, U1.60 (PD13)
PINIO_VTX: Q1.1 (G), R19.1, U1.1 (PE2)
SPI1_MISO: U1.30 (PA6), U2.4 (SAO/SD0)
SPI1_MOSI: U1.88 (PD7), U2.3 (SDA/SDI)
SPI1_SCK: U1.29 (PA5), U2.2 (SCL/SPC)
SPI3_MISO: U1.79 (PC11), U5.2 (DO/IO_{1})
SPI3_MOSI: U1.80 (PC12), U5.5 (DI/IO_{0})
SPI3_SCK: U1.78 (PC10), U5.6 (CLK)
SPI4_MISO: R3.2, R4.2, U1.43 (PE13)
SPI4_MOSI: U1.44 (PE14), U3.9 (SDI/SDA)
SPI4_SCK: U1.42 (PE12), U3.8 (SCK/SCL)
U1_BOOT0: R1.1, SW1.1, U1.94 (BOOT0)
U1_HSE_IN: C12.1, U1.12 (PH0), Y1.1
U1_HSE_OUT: C13.1, U1.13 (PH1), Y1.3
U1_NRST: C11.1, TP3.1, U1.14 (NRST)
U1_SWCLK: TP2.1, U1.76 (PA14)
U1_SWDIO: TP1.1, U1.72 (PA13)
U1_VCAP1: C7.1, U1.48 (VCAP)
U1_VCAP2: C8.1, U1.73 (VCAP)
U2_REGOUT: C16.1, U2.14 (REGOUT)
U3_SDO1: R3.1, U3.15 (SDO1)
U3_SDO2: R4.1, U3.10 (SDO2)
U5_HOLD: R9.2, U5.7 (~HOLD/~RESET/IO_{3})
U5_WP: R8.2, U5.3 (~WP/IO_{2})
U6_CB: C26.1, U6.6 (CB)
U6_EN: R15.2, U6.5 (EN)
U6_FB: R13.2, R14.1, U6.4 (FB)
U6_SW: C26.2, L1.1, U6.2 (SW)
U7_CB: C31.1, U7.6 (CB)
U7_FB: R16.2, R17.1, U7.4 (FB)
U7_SW: C31.2, L2.1, U7.2 (SW)
U8_EN: R20.2, U8.3 (EN)
U9_EN: R21.2, U9.3 (EN)
UART1_RX: TP11.1, U1.69 (PA10)
UART1_TX: TP10.1, U1.68 (PA9)
UART2_RX: J4.4, U1.87 (PD6)
UART2_TX: J4.3, U1.86 (PD5)
UART3_RX: J2.4, U1.56 (PD9)
UART3_TX: J2.3, U1.55 (PD8)
UART4_RX: J1.4, U1.95 (PB8)
UART6_RX: J2.6, TP9.1, U1.64 (PC7)
UART6_TX: TP8.1, U1.63 (PC6)
UART7_RX: J3.3, U1.37 (PE7)
UART7_TX: J3.4, U1.38 (PE8)
USB_DM: J5.A7 (D-), J5.B7 (D-), U1.70 (PA11), U10.3 (I/O2), U10.4 (I/O2)
USB_DP: J5.A6 (D+), J5.B6 (D+), U1.71 (PA12), U10.1 (I/O1), U10.6 (I/O1)
VBAT: C21.1, C24.1, C25.1, C29.1, C30.1, D1.1 (A1), J1.1, R10.1, R15.1, R18.1, U6.3 (VIN), U7.3 (VIN)
VBAT_ADC: C22.1, R10.2, R11.1, U1.15 (PC0)
VBUS: C39.1, D2.2 (A), J5.A4 (VBUS), J5.A9 (VBUS), J5.B4 (VBUS), J5.B9 (VBUS), U10.5 (VBUS)

Notes on the sheet:
STM32H743VIT6, 480 MHz
Gyro 1: ICM-20602 on SPI1 (Betaflight)
Gyro 2: BMI088 on SPI4 (INAV / ArduPilot)
MS5611 on I2C1 (0x77)
16 MB blackbox on SPI3
VBAT in, TVS, sense dividers
5 V / 2 A BEC
10 V / 2 A VTX BEC, switchable
VTX power switch (Betaflight PINIO): high = 10 V off
3V3 for the MCU, flash, baro, LEDs
3V3_GYRO for the two IMUs alone
ESC 8-pin
Digital VTX 6-pin
ELRS receiver 4-pin on UART7
GPS + compass 6-pin
USB-C: configuration, DFU, power on the bench
USB ESD
VBUS into 5V through a Schottky
Buzzer driver (5 V buzzer on the BZ pads)
Status LED 0 (blue)
Status LED 1 (green)
Power LED (red, on 3V3)
Solder pads
30.5 mm stack holes
Power flags

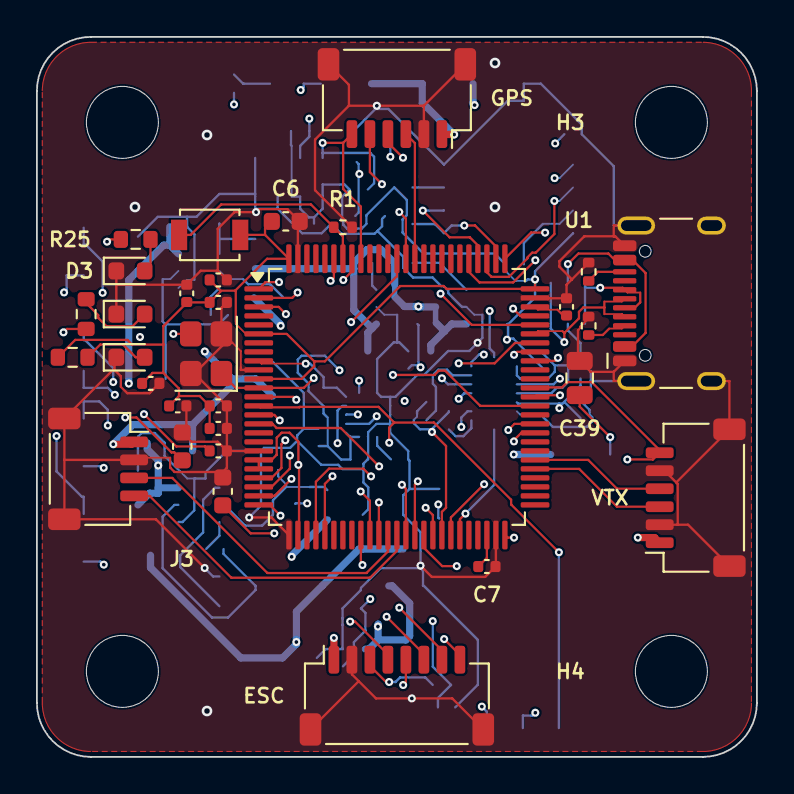
[picture p10: board kestrel_fc.kicad_pcb from above]

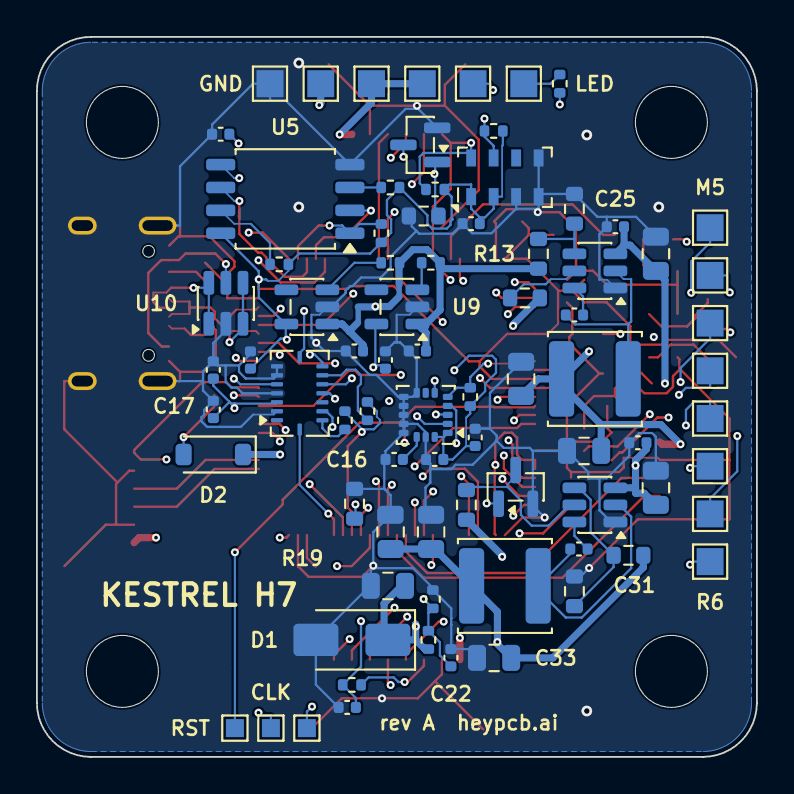
[picture p11: board kestrel_fc.kicad_pcb from below]

Board: 6 copper layers, 40.0 x 40.0 mm, 114 parts (79 on the bottom side), 84 nets.
